Sjin-Lee/Electronic_Engineering_1/Code/Defination.h

#include<Arduino.h>
#include<U8g2lib.h>
#include<Wire.h>
#include<SSD1306.h>
#include<cstdlib>
#include<ESPAsyncWebServer.h>
#include<AsyncTCP.h>
#include<WiFi.h>

#define PWM_FREQ_HZ 6000
#define PWM_RESOLUTION 8

#define PWM_EN1_CH 0
#define PWM_EN2_CH 1

#define HEAD_SENSOR 36  //SVP
#define LEFT_ECHO 35
#define LEFT_TRIG 25
#define RIGHT_ECHO 17
#define RIGHT_TRIG 16
#define FRONT_ECHO 34 
#define FRONT_TRIG 2
#define SCREEN_SCK 22
#define SCREEN_SDA 21
#define AUDIO_PIN 26
#define EN1 5
#define IN1 13
#define IN2 32

#define IN3 14
#define IN4 27
#define EN2 4

#define HAPPY 1
#define SHY 0
#define UNSAFE 9

#define LEFT 3
#define RIGHT 2
#define FRONT 1
#define FORWARD 1
#define STOP 0
#define BACK -1
#define FORCE 9

#define ENGLISHFONT ArialMT_Plain_10

#define SAFETY_DISTANCE 10

#define MOVEONCE 650
#define TURN_DELAYms 148

const char *ssid = "ShyRobot";
const char *password = "group666";

#define LMOTO 33
#define RMOTO 39 //SVN

#define SLOW 135
#define NORMAL 160
#define FAST 170
#define FASTEST 190

#define emotion_width 128
#define emotion_height 47

#define SwiftValue 40

const char* htmlHomePage PROGMEM = R"HTMLHOMEPAGE(
<!DOCTYPE html>
<html>
  <head>
  <meta name="viewport" content="width=device-width, initial-scale=1, maximum-scale=1, user-scalable=no">
    <style>
    .arrows {
      font-size:70px;
      color:rgba(9,255,0, 0.950);
    }
    .speeds{
      font-size:40px;
      color:rgba(178, 255, 123, 0.95);
    }
    
    .circularArrows {
      font-size:80px;
      color:rgb(21, 21, 107);
    }
    td {
      background-color:rgb(255, 2, 2);
      border-radius: 20%;
      box-shadow: 5px 5px #ad5a1e;
    }
    td:active {
      transform: translate(5px,5px);
      box-shadow: none; 
    }

    .noselect {
      -webkit-touch-callout: none; /* iOS Safari */
        -webkit-user-select: none; /* Safari */
         -khtml-user-select: none; /* Konqueror HTML */
           -moz-user-select: none; /* Firefox */
            -ms-user-select: none; /* Internet Explorer/Edge */
                user-select: none; /* Non-prefixed version, currently
                                      supported by Chrome and Opera */
    }
    </style>
  </head>
  <body class="noselect" align="center" style="background-color:rgb(8, 8, 8)">
     
    <h1 style="color: rgb(0, 213, 255);text-align:center;">ShyRobot</h1>
    <h2 style="color: rgb(9, 255, 0);text-align:center;">Wi-Fi &#128663; Control</h2>
    
    <table id="mainTable" style="width:400px;margin:auto;table-layout:fixed" CELLSPACING=12>
      <tr>
        <td></td>
        <td ontouchstart='onTouchStartAndEnd("1")' ontouchend='onTouchStartAndEnd("0")'><span class="arrows" >&#8679;</span></td>
        <td></td>
      </tr>
      
      <tr>
        <td ontouchstart='onTouchStartAndEnd("3")' ontouchend='onTouchStartAndEnd("0")'><span class="arrows" >&#8678;</span></td>
        <td ontouchstart='onTouchStartAndEnd("9")' ontouchend='onTouchStartAndEnd("0")'><span class="arrows"  >&#8855;</span></td>
        <td ontouchstart='onTouchStartAndEnd("2")' ontouchend='onTouchStartAndEnd("0")'><span class="arrows" >&#8680;</span></td>
      </tr>
      
      <tr>
        <td></td>
        <td ontouchstart='onTouchStartAndEnd("-1")' ontouchend='onTouchStartAndEnd("0")'><span class="arrows" >&#8681;</span></td>
        <td></td>
      </tr>
    

    </table>

    <br>
    <h1 style="color: rgb(210, 46, 255);text-align:center;">Speed Switch</h1>

    <table id="SpeedTable" style="width:400px;margin:auto;table-layout:fixed" CELLSPACING=15>
      <tr>
        <td ontouchstart='onTouchStartAndEnd("66")'><span class="speeds">Eco</span></td>
        <td ontouchstart='onTouchStartAndEnd("77")'><span class="speeds" >Norm</span></td>
        <td ontouchstart='onTouchStartAndEnd("99")'><span class="speeds" >Sport</span></td>
      </tr>
    </table>

    <script>
      var webSocketUrl = "ws:\/\/" + window.location.hostname + "/ws";
      var websocket;
      
      function initWebSocket() 
      {
        websocket = new WebSocket(webSocketUrl);
        websocket.onopen    = function(event){};
        websocket.onclose   = function(event){setTimeout(initWebSocket, 2000);};
        websocket.onmessage = function(event){};
      }
      function onTouchStartAndEnd(value) 
      {
        websocket.send(value);
      }
          
      window.onload = initWebSocket;
      document.getElementById("mainTable").addEventListener("touchend", function(event){
        event.preventDefault()
      });      
    </script>
    
  </body>
</html> 
)HTMLHOMEPAGE";


const unsigned char HappyMouth[] = {
  0x00, 0x00, 0x00, 0x00, 0x00, 0x00, 0x00, 0x00, 0x00, 0x00, 0x00, 0x00, 0x00, 0x00, 0x00, 0x00,
  0x00, 0x00, 0x00, 0x00, 0x00, 0x00, 0x00, 0x00, 0x00, 0x00, 0x00, 0x00, 0x00, 0x00, 0x00, 0x00,
  0x00, 0x00, 0x00, 0x00, 0x00, 0x00, 0x00, 0x00, 0x00, 0x00, 0x00, 0x00, 0x00, 0x00, 0x00, 0x00,
  0x00, 0x00, 0x00, 0x00, 0x00, 0x00, 0x00, 0x00, 0x00, 0x00, 0x00, 0x00, 0x00, 0x00, 0x00, 0x00,
  0x00, 0x00, 0x00, 0x00, 0x00, 0x00, 0x00, 0x00, 0x00, 0x00, 0x00, 0x00, 0x00, 0x00, 0x00, 0x00,
  0x00, 0x00, 0x00, 0x00, 0x00, 0x00, 0x00, 0x00, 0x00, 0x00, 0x00, 0x00, 0x00, 0x00, 0x00, 0x00,
  0x00, 0x00, 0x00, 0x00, 0x00, 0x00, 0x00, 0x00, 0x00, 0x00, 0x00, 0x00, 0x00, 0x00, 0x00, 0x00,
  0x00, 0x00, 0x00, 0x00, 0x00, 0x00, 0x00, 0x00, 0x00, 0x00, 0x00, 0x00, 0x00, 0x00, 0x00, 0x00,
  0x00, 0x00, 0x00, 0x00, 0x00, 0x00, 0x00, 0x00, 0x00, 0x00, 0x00, 0x00, 0x00, 0x00, 0x00, 0x00,
  0x00, 0x00, 0x00, 0x00, 0x00, 0x00, 0x00, 0x00, 0x00, 0x00, 0x00, 0x00, 0x00, 0x00, 0x00, 0x00,
  0x00, 0x00, 0x00, 0x00, 0x00, 0x00, 0x00, 0x00, 0x00, 0x00, 0x00, 0x00, 0x00, 0x00, 0x40, 0x00,
  0x00, 0x00, 0x10, 0x00, 0x00, 0x00, 0x00, 0x00, 0x00, 0x00, 0x00, 0x00, 0x00, 0x00, 0xe0, 0x00,
  0x00, 0x00, 0x78, 0x00, 0x00, 0x00, 0x00, 0x00, 0x00, 0x00, 0x00, 0x00, 0x00, 0x00, 0xe0, 0x00,
  0x00, 0x00, 0xf8, 0x01, 0x00, 0x00, 0x00, 0x00, 0x00, 0x00, 0x00, 0x00, 0x00, 0x00, 0xf0, 0x00,
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
	0xC0, 0xBF, 0xC4, 0xCC, 0xD2, 0xC5, 0xBE, 0xA8, 0x94, 0x8B, 0x79, 0x6C,
	0x4E, 0x50, 0x45, 0x51, 0x57, 0x70, 0x74, 0x65, 0x50, 0x4E, 0x53, 0x86,
	0x9A, 0xA0, 0x89, 0x7A, 0x6F, 0x84, 0x8E, 0xA3, 0xA5, 0x9D, 0x91, 0x8B,
	0x8D, 0x84, 0x83, 0x6B, 0x60, 0x61, 0x74, 0x81, 0x6C, 0x62, 0x4B, 0x4F,
	0x62, 0x7A, 0x84, 0x89, 0x80, 0x8B, 0x8A, 0x8C, 0x94, 0xA7, 0xB7, 0xAE,
	0xA3, 0x9B, 0x86, 0x75, 0x69, 0x59, 0x4C, 0x62, 0x63, 0x5D, 0x6A, 0x5C,
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
};

#define CarEngineLen 9674
void PlayCarEngine(){
	for(int i=0;i<CarEngineLen;i++){
		dacWrite(AUDIO_PIN,CarEngine[i]-SwiftValue);
		delayMicroseconds(25);
	}
}
