Sjin-Lee/Electronic_Engineering_1/PreHomework-Tests/Test4/Test4.ino

#include <Arduino.h>
//Key：Yellow=Red+Green
#define PWM_FREQ_HZ        2000
#define PWM_CH_LED_RED     0
#define PWM_CH_LED_GREEN   1
#define PWM_CH_LED_BLUE    2
#define PWM_CH_LED_ONBOARD 3
#define PWM_RESOLUTION     8

#define PIN_LED_RED     16
#define PIN_LED_GREEN   17
#define PIN_LED_BLUE    18
#define PIN_LED_ONBOARD 2

#define PIN_LightRecv 34

int PWMRedValue=0;
int PWMGreenValue=0;
int PWMBlueValue=0;
int PWMOnBoardValue=0;

void setup()
{
    Serial.begin(115200);
    pinMode(PIN_LED_RED, OUTPUT);
    pinMode(PIN_LED_GREEN, OUTPUT);
    pinMode(PIN_LED_BLUE, OUTPUT);
    pinMode(PIN_LED_ONBOARD, OUTPUT);

    ledcSetup(PWM_CH_LED_RED,     PWM_FREQ_HZ, PWM_RESOLUTION); 
    ledcSetup(PWM_CH_LED_GREEN,   PWM_FREQ_HZ, PWM_RESOLUTION); 
    ledcSetup(PWM_CH_LED_BLUE,    PWM_FREQ_HZ, PWM_RESOLUTION); 
    ledcSetup(PWM_CH_LED_ONBOARD, PWM_FREQ_HZ, PWM_RESOLUTION); 
  
    ledcAttachPin(PIN_LED_RED,    PWM_CH_LED_RED);   
    ledcAttachPin(PIN_LED_GREEN,  PWM_CH_LED_GREEN);
    ledcAttachPin(PIN_LED_BLUE,   PWM_CH_LED_BLUE);
    ledcAttachPin(PIN_LED_ONBOARD,PWM_CH_LED_ONBOARD);

    pinMode(PIN_LightRecv,INPUT);
}

void loop()
{
    ledcWrite(PWM_CH_LED_RED,PWMRedValue);
    ledcWrite(PWM_CH_LED_GREEN,PWMGreenValue);
    ledcWrite(PWM_CH_LED_ONBOARD,PWMOnBoardValue);
    int Bright=0;
    Bright=analogRead(PIN_LightRecv);
    Serial.print("P34引脚的电压 = ");
    Serial.print(Bright);
    Serial.print("    ");
    Serial.print(Bright*3.3/4096);
    Serial.print(" V   ");
    if(Bright<100)Bright=100;
    if(Bright>4095)Bright=4095;
    //Bright 100-4095映射到0-255 * 4之间的值
    Bright=(Bright-100)*255 * 4/(4095-100);
    Serial.print("Bright=   ");
    Serial.println(Bright);
    //Bright -> different color
    
    if(Bright>=0 && Bright<= 255){
        PWMRedValue=Bright;
        PWMGreenValue=0;
        PWMBlueValue=0;
    }
    if(Bright>=256 && Bright<= 511){
        PWMRedValue=0;
        PWMGreenValue=0;
        PWMBlueValue=Bright-256;
    }
    if(Bright>=512 && Bright<= 767){
        PWMRedValue=0;
        PWMGreenValue=Bright-512;
        PWMBlueValue=0;
    }
    if(Bright>=768 && Bright<= 1023){
        PWMRedValue=Bright-768;
        PWMGreenValue=Bright-768;
        PWMBlueValue=Bright-768;
    }
    delay(100);
}
