Sjin-Lee/Electronic_Engineering_1/PreHomework-Tests/Test2/Test2-TenHeaderFileVersion/Nine.h

unsigned char NineData[23942] = {
	0x52, 0x49, 0x46, 0x46, 0x7E, 0x5D, 0x00, 0x00, 0x57, 0x41, 0x56, 0x45,
	0x66, 0x6D, 0x74, 0x20, 0x10, 0x00, 0x00, 0x00, 0x01, 0x00, 0x01, 0x00,
	0x80, 0xBB, 0x00, 0x00, 0x80, 0xBB, 0x00, 0x00, 0x01, 0x00, 0x08, 0x00,
	0x64, 0x61, 0x74, 0x61, 0xFD, 0x5C, 0x00, 0x00, 0x80, 0x7F, 0x80, 0x80,
	0x80, 0x7F, 0x80, 0x7F, 0x80, 0x80, 0x7F, 0x80, 0x7F, 0x80, 0x7F, 0x80,
	0x7F, 0x80, 0x7F, 0x7F, 0x80, 0x80, 0x80, 0x7E, 0x80, 0x7F, 0x80, 0x7F,
	0x80, 0x80, 0x80, 0x80, 0x7F, 0x80, 0x7F, 0x7F, 0x80, 0x7F, 0x80, 0x80,
	0x7F, 0x80, 0x7F, 0x81, 0x7F, 0x80, 0x7F, 0x80, 0x7F, 0x81, 0x80, 0x7F,
	0x80, 0x7F, 0x7F, 0x81, 0x80, 0x80, 0x80, 0x7E, 0x80, 0x7F, 0x80, 0x80,
	0x80, 0x7F, 0x7F, 0x80, 0x7F, 0x80, 0x7F, 0x7F, 0x7F, 0x7F, 0x7F, 0x80,
	0x7F, 0x80, 0x80, 0x7F, 0x80, 0x7F, 0x80, 0x80, 0x80, 0x7F, 0x7F, 0x80,
	0x7F, 0x80, 0x80, 0x7F, 0x80, 0x7F, 0x80, 0x7F, 0x80, 0x80, 0x80, 0x80,
	0x7F, 0x80, 0x80, 0x80, 0x7E, 0x81, 0x80, 0x80, 0x7F, 0x80, 0x7F, 0x80,
	0x7F, 0x80, 0x7F, 0x80, 0x7F, 0x80, 0x7F, 0x80, 0x81, 0x80, 0x80, 0x7F,
	0x80, 0x7E, 0x80, 0x7F, 0x7F, 0x7F, 0x80, 0x80, 0x7F, 0x7F, 0x80, 0x7F,
	0x81, 0x7F, 0x7F, 0x7F, 0x7F, 0x80, 0x80, 0x80, 0x80, 0x7E, 0x80, 0x7F,
	0x7F, 0x80, 0x80, 0x7F, 0x80, 0x7F, 0x80, 0x81, 0x80, 0x80, 0x80, 0x7F,
	0x80, 0x80, 0x7F, 0x7F, 0x80, 0x80, 0x80, 0x80, 0x7F, 0x80, 0x7F, 0x80,
	0x7F, 0x80, 0x7F, 0x80, 0x7F, 0x80, 0x7F, 0x80, 0x80, 0x7E, 0x80, 0x80,
	0x7F, 0x80, 0x80, 0x81, 0x80, 0x7F, 0x7F, 0x7E, 0x80, 0x80, 0x80, 0x80,
	0x7F, 0x80, 0x7F, 0x81, 0x7F, 0x7F, 0x80, 0x7F, 0x80, 0x80, 0x7F, 0x80,
	0x7F, 0x80, 0x80, 0x7E, 0x80, 0x7E, 0x80, 0x7F, 0x81, 0x7F, 0x81, 0x7F,
	0x7F, 0x80, 0x7F, 0x80, 0x7E, 0x80, 0x7F, 0x80, 0x7F, 0x7F, 0x7F, 0x80,
	0x7E, 0x80, 0x80, 0x7F, 0x80, 0x7F, 0x81, 0x7F, 0x80, 0x80, 0x80, 0x7F,
	0x80, 0x80, 0x80, 0x80, 0x80, 0x80, 0x80, 0x80, 0x80, 0x81, 0x7F, 0x80,
	0x7E, 0x80, 0x7F, 0x80, 0x7F, 0x80, 0x80, 0x7F, 0x80, 0x7F, 0x80, 0x80,
	0x7F, 0x80, 0x7F, 0x80, 0x80, 0x7F, 0x80, 0x7F, 0x80, 0x80, 0x80, 0x80,
	0x80, 0x80, 0x80, 0x7E, 0x7F, 0x7E, 0x7F, 0x7E, 0x80, 0x7F, 0x80, 0x80,
	0x80, 0x80, 0x81, 0x7F, 0x80, 0x80, 0x80, 0x80, 0x7F, 0x80, 0x7E, 0x81,
	0x7F, 0x80, 0x7F, 0x7F, 0x7F, 0x80, 0x7F, 0x7F, 0x80, 0x80, 0x80, 0x80,
	0x7F, 0x80, 0x7F, 0x80, 0x7F, 0x80, 0x7F, 0x80, 0x80, 0x80, 0x80, 0x80,
	0x81, 0x7F, 0x81, 0x80, 0x80, 0x7F, 0x80, 0x80, 0x80, 0x80, 0x80, 0x80,
	0x80, 0x7F, 0x7F, 0x80, 0x7F, 0x80, 0x80, 0x81, 0x80, 0x80, 0x7F, 0x80,
	0x7F, 0x80, 0x80, 0x7F, 0x7F, 0x7E, 0x80, 0x80, 0x7F, 0x80, 0x7F, 0x81,
	0x80, 0x7E, 0x80, 0x7F, 0x80, 0x80, 0x7F, 0x81, 0x80, 0x7F, 0x81, 0x7F,
	0x7F, 0x7F, 0x7F, 0x80, 0x7F, 0x81, 0x80, 0x80, 0x81, 0x7F, 0x80, 0x80,
	0x7F, 0x7F, 0x80, 0x7F, 0x80, 0x7F, 0x80, 0x7F, 0x80, 0x80, 0x80, 0x80,
	0x80, 0x7F, 0x81, 0x7F, 0x80, 0x7F, 0x80, 0x7F, 0x7F, 0x7F, 0x80, 0x7F,
	0x80, 0x7F, 0x80, 0x80, 0x7F, 0x80, 0x80, 0x80, 0x7F, 0x80, 0x7F, 0x80,
	0x7F, 0x80, 0x80, 0x7F, 0x80, 0x7F, 0x80, 0x80, 0x7F, 0x80, 0x7F, 0x80,
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
};
